james-clarke-audio/E4/documents/3d Files/motormountfinal.stl

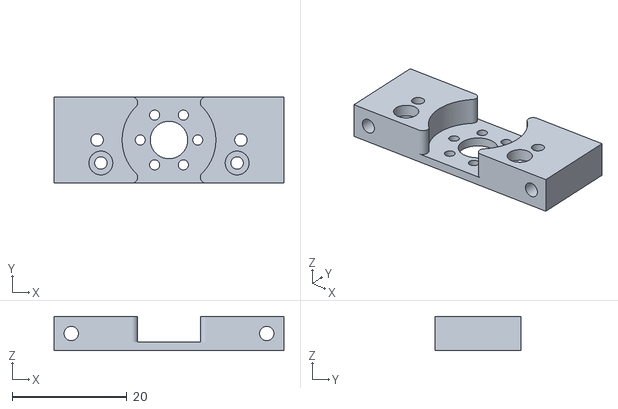
[picture p1: CAD file, 2024-05-07]
documents/3d Files/motormountfinal.stl
40.0 x 15.0 x 6.00
