james-clarke-audio/E4/documents/3d Files/SensorHousing.stl

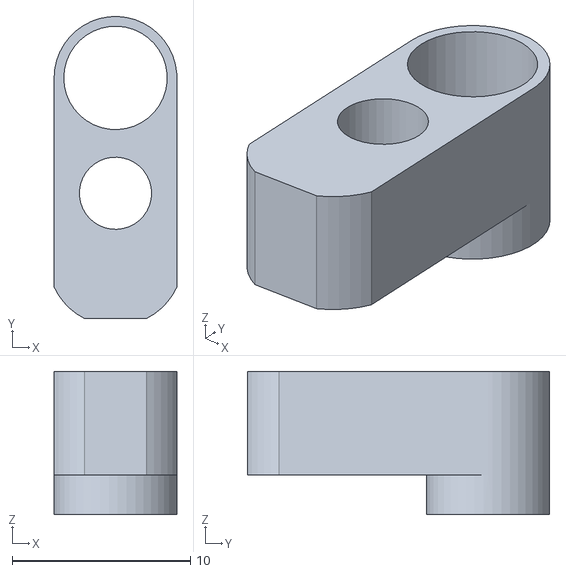
[picture p2: CAD file, 2024-05-07]
documents/3d Files/SensorHousing.stl
6.89 x 16.9 x 8.03
