james-clarke-audio/E4/documents/3d Files/wheel195mm.stl

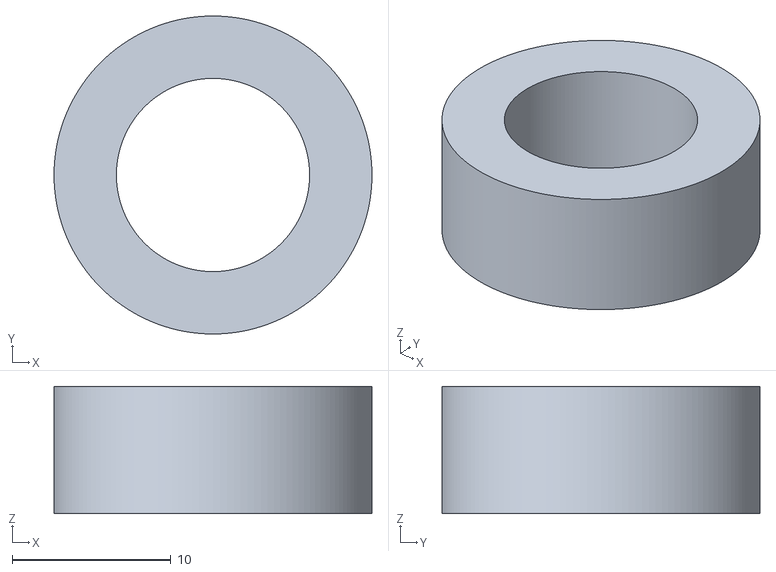
[picture p3: CAD file, 2024-05-07]
documents/3d Files/wheel195mm.stl
20.0 x 20.0 x 8.00
