james-clarke-audio/E4/documents/3d Files/Wheel185mm.stl

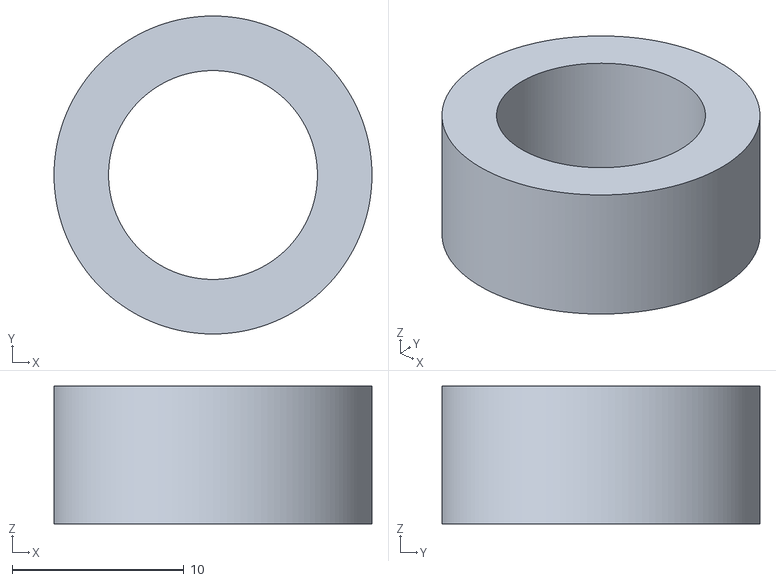
[picture p4: CAD file, 2024-05-07]
documents/3d Files/Wheel185mm.stl
18.5 x 18.5 x 8.00
