james-clarke-audio/E4/documents/schematics/E4-blackpill-v2.brd

## EAGLE design documents/schematics/E4-blackpill-v2.brd (2024-05-07)

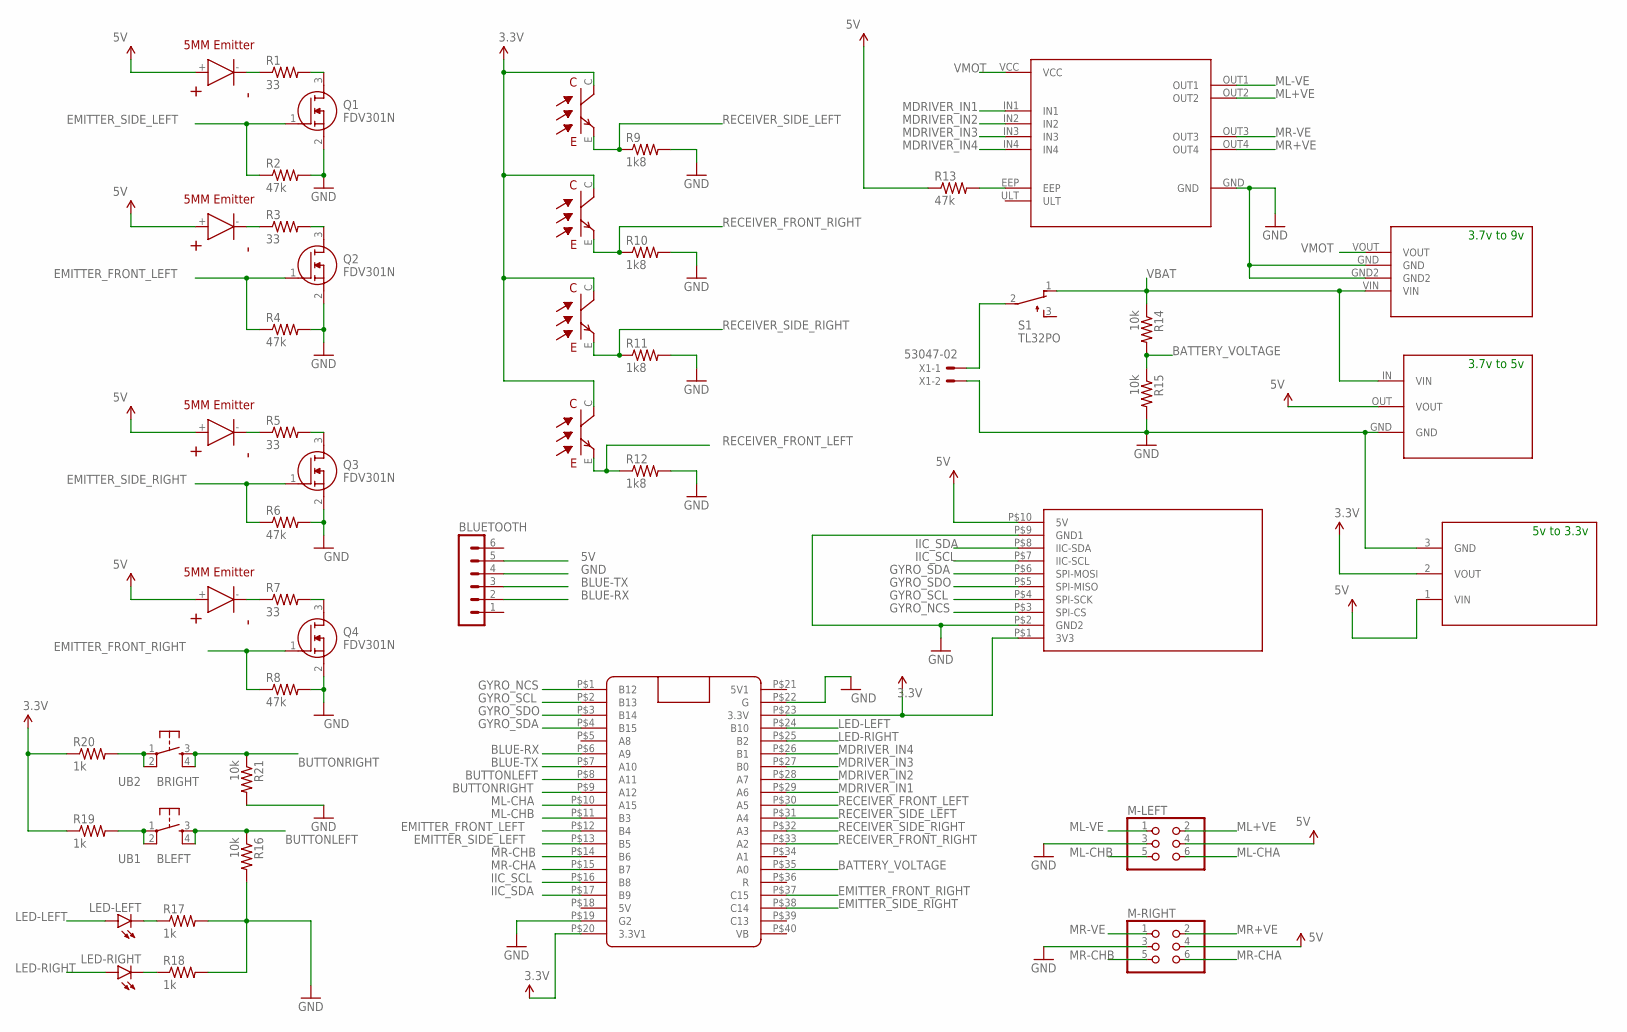
[picture p5: schematic E4-blackpill-v2.sch]

Parts:
BLUETOOTH: MA06-1
DET-FRONTLEFT: RECEIVER
DET-FRONTRIGHT: RECEIVER
DET-SIDELEFT: RECEIVER
DET-SIDERIGHT: RECEIVER
IR-FRONTLEFT: EMITTER
IR-FRONTRIGHT: EMITTER
IR-SIDELEFT: EMITTER
IR-SIDERIGHT: EMITTER
LED-LEFT: LEDSML0603; SML0603
LED-RIGHT: LEDSML0603; SML0603
M-LEFT: PINHD-2X3; 2X03
M-RIGHT: PINHD-2X3; 2X03
Q1, Q2, Q3, Q4: FDV301N; SOT96P237X111-3N
R1, R3, R5, R7: 33; 1206
R2, R4, R6, R8, R13: 47k; 0603-RES
R9, R10, R11, R12: 1k8; 0603-RES
R14, R15, R16, R21: 10k; 0603-RES
R17, R18, R19, R20: 1k; 0603-RES
S1: TL32PO; TL3XPO
U$1: E4_SPI-IIC
U$3: DRV8833
U$4: BUCK3TO9BUCK3TO9-HORIZONTAL; BUCK3TO9-HORIZONTAL
U$5: BUCK3TO5; BUCK3TO5-H
U$7: BLACK_PILL
U$8: 3V3-CONV3V3CONV; 6410-03
UB1: BLEFT; TACTILE-PTH
UB2: BRIGHT; TACTILE-PTH
X1: 53047-02

Connections:
3.3V: DET-FRONTLEFT.C, DET-FRONTRIGHT.C, DET-SIDELEFT.C, DET-SIDERIGHT.C, R19.1, R20.1, U$1.P$1 (3V3), U$7.P$20 (3.3V1), U$7.P$23 (3.3V), U$8.2 (VOUT)
5V: BLUETOOTH.5, IR-FRONTLEFT.+, IR-FRONTRIGHT.+, IR-SIDELEFT.+, IR-SIDERIGHT.+, M-LEFT.4, M-RIGHT.4, R13.1, U$1.P$10 (5V), U$5.OUT (VOUT), U$8.1 (VIN)
5V1: U$7.P$21 (5V1)
BATTERY_VOLTAGE: R14.2, R15.1, U$7.P$35 (A0)
BLUE-RX: BLUETOOTH.2, U$7.P$6 (A9)
BLUE-TX: BLUETOOTH.3, U$7.P$7 (A10)
BUTTONLEFT: R16.1, U$7.P$8 (A11), UB1.3, UB1.4
BUTTONRIGHT: R21.1, U$7.P$9 (A12), UB2.3, UB2.4
EMITTER_FRONT_LEFT: Q2.1 (G), R4.1, U$7.P$12 (B4)
EMITTER_FRONT_RIGHT: Q4.1 (G), R8.1, U$7.P$37 (C15)
EMITTER_SIDE_LEFT: Q1.1 (G), R2.1, U$7.P$13 (B5)
EMITTER_SIDE_RIGHT: Q3.1 (G), R6.1, U$7.P$38 (C14)
GND: BLUETOOTH.4, M-LEFT.3, M-RIGHT.3, Q1.2 (S), Q2.2 (S), Q3.2 (S), Q4.2 (S), R2.2, R4.2, R6.2, R8.2, R9.2, R10.2, R11.2, R12.2, R15.2, R16.2, R17.2, R18.2, R21.2, U$1.P$2 (GND2), U$1.P$9 (GND1), U$3.GND, U$4.GND, U$4.GND2, U$5.GND, U$7.P$19 (G2), U$7.P$22 (G), U$8.3 (GND), X1.2
GYRO_NCS: U$1.P$3 (SPI-CS), U$7.P$1 (B12)
GYRO_SCL: U$1.P$4 (SPI-SCK), U$7.P$2 (B13)
GYRO_SDA: U$1.P$6 (SPI-MOSI), U$7.P$4 (B15)
GYRO_SDO: U$1.P$5 (SPI-MISO), U$7.P$3 (B14)
IIC_SCL: U$1.P$7 (IIC-SCL), U$7.P$16 (B8)
IIC_SDA: U$1.P$8 (IIC-SDA), U$7.P$17 (B9)
LED-LEFT: LED-LEFT.A, U$7.P$24 (B10)
LED-RIGHT: LED-RIGHT.A, U$7.P$25 (B2)
MDRIVER_IN1: U$3.IN1, U$7.P$29 (A6)
MDRIVER_IN2: U$3.IN2, U$7.P$28 (A7)
MDRIVER_IN3: U$3.IN3, U$7.P$27 (B0)
MDRIVER_IN4: U$3.IN4, U$7.P$26 (B1)
ML+VE: M-LEFT.2, U$3.OUT2
ML-CHA: M-LEFT.6, U$7.P$10 (A15)
ML-CHB: M-LEFT.5, U$7.P$11 (B3)
ML-VE: M-LEFT.1, U$3.OUT1
MR+VE: M-RIGHT.2, U$3.OUT4
MR-CHA: M-RIGHT.6, U$7.P$15 (B7)
MR-CHB: M-RIGHT.5, U$7.P$14 (B6)
MR-VE: M-RIGHT.1, U$3.OUT3
unnamed: IR-FRONTRIGHT.-, R7.1
unnamed: Q1.3 (D), R1.2
unnamed: IR-SIDELEFT.-, R1.1
unnamed: IR-FRONTLEFT.-, R3.1
unnamed: Q2.3 (D), R3.2
unnamed: Q4.3 (D), R7.2
unnamed: IR-SIDERIGHT.-, R5.1
unnamed: Q3.3 (D), R5.2
unnamed: R13.2, U$3.EEP
unnamed: LED-RIGHT.C, R18.1
unnamed: LED-LEFT.C, R17.1
unnamed: R19.2, UB1.1, UB1.2
unnamed: R20.2, UB2.1, UB2.2
unnamed: S1.2, X1.1
RECEIVER_FRONT_LEFT: DET-FRONTLEFT.E, R12.1, U$7.P$30 (A5)
RECEIVER_FRONT_RIGHT: DET-FRONTRIGHT.E, R10.1, U$7.P$33 (A2)
RECEIVER_SIDE_LEFT: DET-SIDELEFT.E, R9.1, U$7.P$31 (A4)
RECEIVER_SIDE_RIGHT: DET-SIDERIGHT.E, R11.1, U$7.P$32 (A3)
VBAT: R14.1, S1.1 (O), U$4.VIN, U$5.IN (VIN)
VMOT: U$3.VCC, U$4.VOUT

Notes on the sheet:
3.7v to 9v
3.7v to 5v
5v to 3.3v

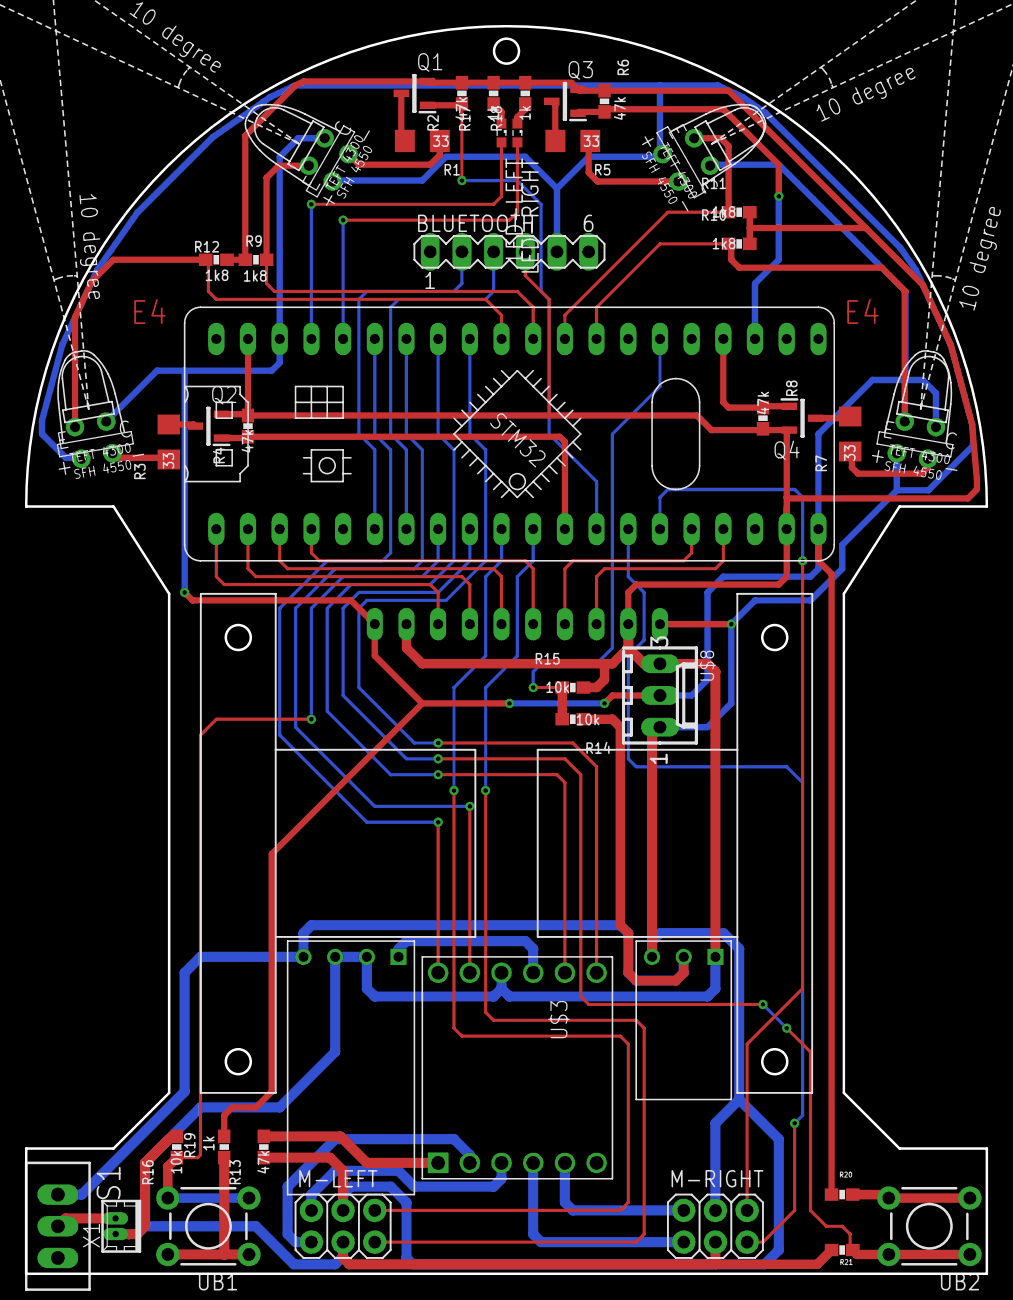
[picture p6: board E4-blackpill-v2.brd from above]

Board: 2 copper layers, 77.0 x 100.0 mm, 48 parts (0 on the bottom side), 52 nets.
