james-clarke-audio/E4/documents/release_notes.txt

01 May 2024 - version 0.0.1

Having isolated compiler issues within the platformio system.  I am now in a position to start to migrate all the code into a new defined project.

ECAC is a continuation of my university masters thesis and attempts to move from an overhead sensor arrangement to side facing sensors.

Purpose:
Build framework of application:

Complete.  Included within documents is a template to use for headers that forces the compiler to use c++ rather than c.

Build macros for fixed inputs/outputs:  switches, leds (visual), leds (infrared):

Build display class: Complete 17 May 2024
interfaces with I2C class
Use as follows:

#include <display.h>

#define SCL_PIN GPIO_PIN_8
#define SDA_PIN GPIO_PIN_9
#define I2C_MODULE_1                  ((uint16_t)0x0001)
#define I2C_MODULE_2                  ((uint16_t)0x0002)

// create object for OLED display
// see config-blackpill.h for pin definitions
Display display(SDA_PIN, SCL_PIN, I2C_MODULE_1); 
FontDef_t Font_6x8 = {6, 8, Font6x8};
display.Init();  /* initialise LCD display on I2C bus */

/* Welcome to E4! */
display.GotoXY (5, 1);
display.Print ("Welcome to E4", Font_6x8, COLOR_WHITE);
display.GotoXY (5, 8);
display.Print ("(c) James Clarke", Font_6x8, COLOR_WHITE);
