james-clarke-audio/E4/(commit log)

2024-05-07 Add Documents to repo
    Add base documents to repository
    [E4-blackpill-v2.brd, E4-blackpill-v2.sch, OLED-GYRO.brd, OLED-GYRO.sch, SensorHousing.stl, Wheel185mm.stl, assembly.csv, bom.csv]
2024-05-16 Migration of code
    Migrated OLED (display) and I2C to lib folder and converted to c++ class
2024-05-23 Encoder Modules
    Need to update
2024-05-23 Update encoder.cpp
    update
2024-05-23 Encoders phase 1 complete
    Encoders working. Created new timer object and passed in
2024-05-24 Added print float and integer functions
    Added print float and integer functions
2024-06-02 new OLED board
    Added IIC eeprom to the OLED / Gyro board
